pepemanboy/sumitomo_cpgs/electronics/cpg_slave_sch.PDF

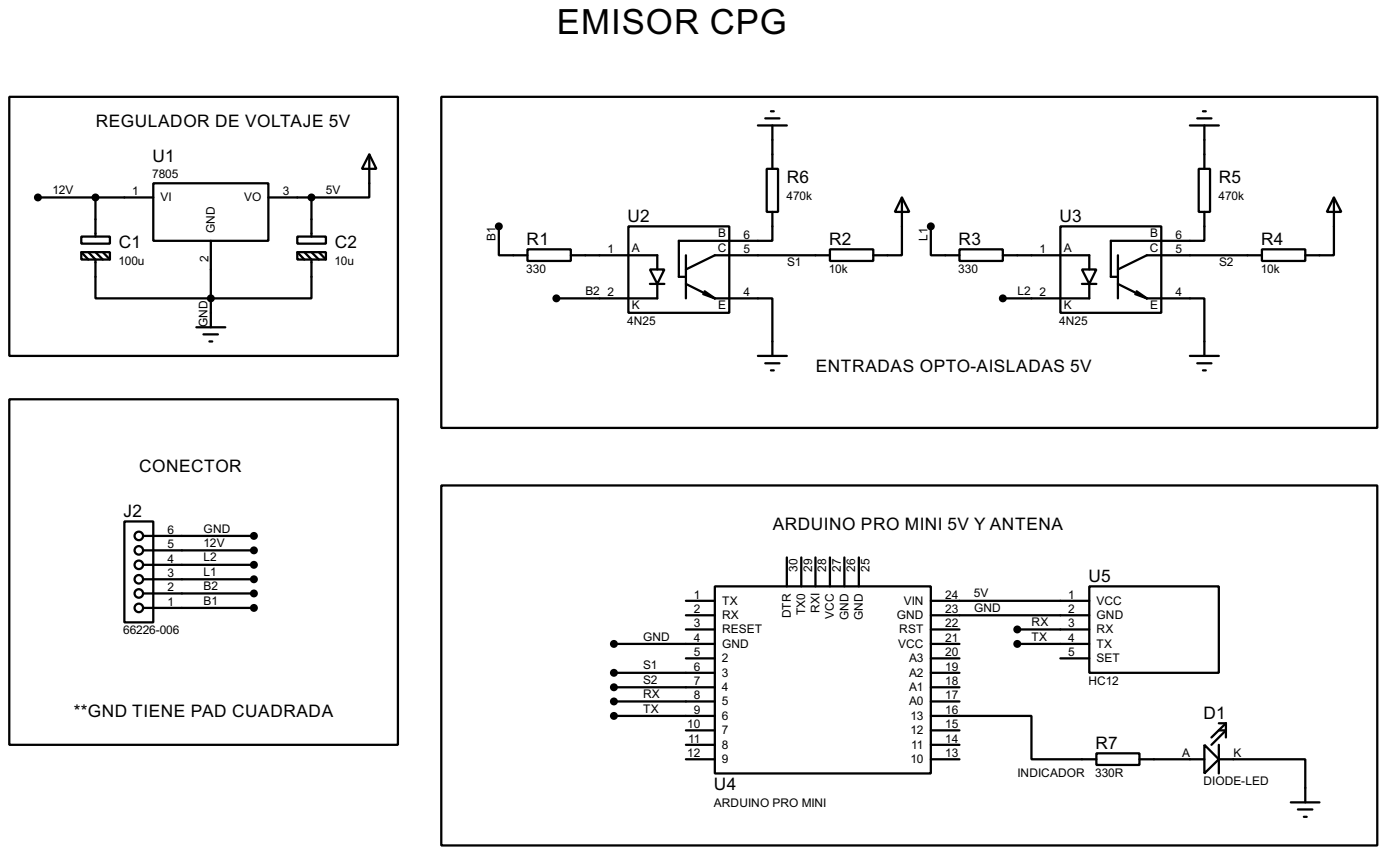
[picture p3: page 1]

ARDUINO PRO MINI 5V Y ANTENA

**GND TIENE PAD CUADRADA
