pepemanboy/sumitomo_cpgs/src/sumitomo_cpgs_master.h

/** @file
  CPG Master implementation

  Defines the CPG_Master class, wich inherits from CPG. 

  @date 2019-01-31
  @author pepemanboy

  Copyright 2019 Cirotec Automation

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
  THE SOFTWARE IS PROVIDED "AS IS", WITHOUT WARRANTY OF ANY KIND, EXPRESS OR 
  IMPLIED, INCLUDING BUT NOT LIMITED TO THE WARRANTIES OF MERCHANTABILITY, 
  FITNESS FOR A PARTICULAR PURPOSE AND NONINFRINGEMENT. IN NO EVENT SHALL THE 
  AUTHORS OR COPYRIGHT HOLDERS BE LIABLE FOR ANY CLAIM, DAMAGES OR OTHER 
  LIABILITY, WHETHER IN AN ACTION OF CONTRACT, TORT OR OTHERWISE, ARISING FROM, 
  OUT OF OR IN CONNECTION WITH THE SOFTWARE OR THE USE OR OTHER DEALINGS IN THE 
  SOFTWARE.
*/

#include "sumitomo_cpgs_common.h"
#include "sumitomo_cpgs_config.h"

#ifndef SUMITOMO_CPGS_MASTER_H
#define SUMITOMO_CPGS_MASTER_H

class CPG_Master:CPG
{

private:
  /// GET CONFIGURATION FROM FILE
  const static uint8_t slave_number_ = {
    SUMITOMO_CPGS_CONFIG_SLAVE_NUMBER
  }; ///< Number of slaves for this master
  const uint8_t slaves_[slave_number_] = {
     #include "../cfg/slaves_config.h"
  }; ///< Slaves addressable by this master
  const static uint8_t master_channel_ = {
    #include "../cfg/master_channel_config.h"
  }; ///< Master HC12 channel

  /// CONFIGURATION
  const static pin_t led_blue_ = 8; ///< Blue LED
  const static pin_t hc12_tx_ = 3; ///< HC12 Tx pin
  const static pin_t hc12_rx_ = 2; ///< HC12 Rx pin
  const static pin_t hc12_set_ = 7; ///< HC12 Set pin
  
  const static uint16_t rx_blink_ms_ = 200; ///< Blink time on RX
  const static uint32_t init_period_ms_ = 60000 + (master_channel_*10); ///< Init query period
  const static uint32_t slave_period_ms_ = 1000; ///< Slave query period
  const static uint16_t serial_timeout_ms_ = 1000; ///< Serial timeout [ms]

  /// VARIABLES
  uint32_t led_timestamp_ = 0; ///< Timestamp of LED turn on
  uint32_t serial_timestamp_ = 0; ///< Timestamp of serial
  uint32_t init_timestamp_ = 0; ///< Timestamp for last init query
  uint32_t slave_timestamp_ = 0; ///< Timestamp for slave querying

  uint8_t sequences_[slave_number_] = {0}; ///< Sequences of slaves
  uint32_t slaves_mask_ = 0;


public:
  /** Constructor */
  CPG_Master():
  CPG(hc12_tx_,hc12_rx_,hc12_set_, led_blue_, serial_timeout_ms_)
  {
    setAddress(master_address_);
    slaves_mask_ = 0;
    for (uint8_t i = 0; i < slave_number_; ++i)
      slaves_mask_ |= ((uint32_t)1)<<slaves_[i];    
  }

/// PACKET QUERIES
private:
  /** Query CPG Info */
  void queryCPGInfo(uint8_t address, const CPGInfoQuery * c)
  {
    queryPacket(address, cmd_CPGInfoQuery, (uint8_t *)c, sizeof(CPGInfoQuery)); 
  }

  /** Query CPG Init */
  void queryCPGInit(const CPGInitQuery * c)
  {
    queryPacket(broadcast_address_, cmd_CPGInitQuery, (uint8_t *)c, sizeof(CPGInitQuery)); 
  }
  
private:
  /** Setup led module */
  void ledSetup()
  {
    pinMode(led_blue_, OUTPUT);
    ledControl(led_blue_, led_On);
  }

  void ledBlinkStart()
  {
    ledControl(led_blue_, led_On);
    led_timestamp_ = millis();
  }

  void ledBlinkReset()
  {
    if ((millis() - led_timestamp_) > rx_blink_ms_)
      ledControl(led_blue_, led_Off);
  }

public: 
  /** Setup */ 
  void setup()
  {
    USB.begin(usb_baudrate_);
    
    ledSetup();
    HC12_setup_retry(home_channel_);
      
    CPGInitQuery c = {
      .cpg_channel = master_channel_, 
      .cpg_address = slaves_mask_
    };

    queryCPGInit(&c);
    debug((char *)"Sent query CPG Init");
    delay(100);
    
    HC12_setup_retry(master_channel_);
  }

  /** Loop */
  void loop() 
  {    
    res_t r = Ok;
    
    ledBlinkReset();

    for (uint8_t i; i < slave_number_; ++i)
    {
      // Time control
      while ((millis() - slave_timestamp_) < slave_period_ms_)
      {
        ledBlinkReset();
        delay(10);
      }
      slave_timestamp_ = millis();

      // Reset blinking LED
      ledBlinkReset();

      // Clean rx buffer
      while(HC12.available()) 
        HC12.read();

      // Query Info
      CPGInfoQuery c = {.cpg_sequence = sequences_[i]};
      queryCPGInfo(slaves_[i], &c);

      // Debug
      #ifdef DEBUG
      char buf[10] = "";
      sprintf(buf, "qry slv %d", slaves_[i]);
      debug(buf);
      #endif

      // Wait for reply
      size_t l = HC12.readBytesUntil(0, rx_buffer_, sizeof(rx_buffer_));

      // Process reply
      if (l)
      {        
        debug((char *)"Received reply");
        packet_t *p = &rx_packet_;
        r = packetRx(p, rx_buffer_, l);
        if (r == Ok) 
        {                
          if (p->command == cmd_CPGInfoReply && 
            p->data_size == sizeof(CPGInfoReply)) 
          {
            CPGInfoReply *rpy = (CPGInfoReply*)p->data;
            if (rpy->cpg_id == slaves_[i])
            {
              sequences_[i] = rpy->cpg_sequence;
              for (uint8_t j = 0; j < rpy->cpg_count; ++j)
                USB.println(rpy->cpg_id);
              ledBlinkStart();
            }
            else // Id mismatch
            {
              debug((char *)"Id error");
              r = EId;
            }
          }
          else // Command mismatch
          {
            debug((char *)"Command error");
            r = ECommand;            
          }
        }
      }
      else
      {
        debug((char *)"No reply");
      }

    }

    // Send slaves
    if ((millis() - init_timestamp_) > init_period_ms_)
    {
      debug((char *)"Send init");
      HC12_setup_retry(home_channel_);
      CPGInitQuery c = {
      .cpg_channel = master_channel_, 
      .cpg_address = slaves_mask_
      };
      queryCPGInit(&c);
      delay(100);
      HC12_setup_retry(master_channel_);
      debug((char *)"Finish sending init");
      init_timestamp_ = millis();
    }

  }
};

#endif // SUMITOMO_CPGS_MASTER_H
