pepemanboy/sumitomo_cpgs/sumitomo_cpgs_master.h

#include "sumitomo_cpgs_common.h"
#include "sumitomo_cpgs_config.h"

class CPG_Master:CPG
{

private:
  /// CONFIGURATION
  const static pin_t led_blue_ = 8; ///< Blue LED
  const static pin_t hc12_tx_ = 3; ///< HC12 Tx pin
  const static pin_t hc12_rx_ = 2; ///< HC12 Rx pin
  const static pin_t hc12_set_ = 7; ///< HC12 Set pin
  
  const static uint16_t rx_blink_ms_ = 200; ///< Blink time on RX
  const static uint8_t master_channel_ = cpg_MASTER_CHANNEL; ///< Master HC12 channel
  const static uint16_t reply_timeout_ms = 100; ///< Reply timeout
  
  const static uint8_t slave_number_ = cpg_SLAVE_NUMBER; ///< Number of slaves for this master
  const uint8_t slaves_[cpg_SLAVE_NUMBER] = cpg_SLAVES; ///< Slaves for this master

  const static uint8_t fault_threshold_ = 10; ///< Allowed consecutive faults from a slave

  /// VARIABLES
  uint32_t led_timestamp_ = 0; ///< Timestamp of LED turn on
  uint32_t serial_timestamp_ = 0; ///< Timestamp of serial

  uint8_t sequences_[slave_number_] = {0}; ///< Sequences of slaves
  uint8_t faults_[slave_number_] = {0}; ///< Faults of slaves

public:
  /** Constructor */
  CPG_Master():
  CPG(hc12_tx_,hc12_rx_,hc12_set_, led_blue_)
  {
    setAddress(master_address_);
  }

/// PACKET QUERIES
private:
  /** Query CPG Info */
  void queryCPGInfo(uint8_t address, const CPGInfoQuery * c)
  {
    queryPacket(address, cmd_CPGInfoQuery, (uint8_t *)c, sizeof(c)); 
  }

  /** Query CPG Init */
  void queryCPGInit(const CPGInitQuery * c)
  {
    queryPacket(broadcast_address_, cmd_CPGInitQuery, (uint8_t *)c, sizeof(c)); 
  }
  
private:
  /** Setup led module */
  void ledSetup()
  {
    pinMode(led_blue_, OUTPUT);
    ledControl(led_blue_, led_On);
  }

public: 
  /** Setup */ 
  void setup()
  {
    USB.begin(usb_baudrate_);
    
    ledSetup();
    res_t res = HC12_setup(home_channel_);
    if (res != Ok)
      error();
      
    uint32_t init_slaves_ = 0;
    for (uint8_t i = 0; i < slave_number_; ++i)
      init_slaves_ |= 1<<slaves_[i];    
      
    CPGInitQuery c = {.cpg_channel = master_channel_, .cpg_address = init_slaves_};
    queryCPGInit(&c);
    
    HC12_setup(master_channel_);
  }

  /** Loop */
  void loop() 
  {
    res_t r = Ok;
    uint32_t init_slaves_ = 0;
    for (uint8_t i; i < slave_number_; ++i)
    {
      // Clean rx buffer
      while(HC12.available()) 
        HC12.read();

      // Query Info
      CPGInfoQuery c = {.cpg_sequence = sequences_[i]};
      queryCPGInfo(slaves_[i], &c);

      // Wait for reply
      size_t l = HC12.readBytesUntil(0, rx_buffer_, sizeof(rx_buffer_));

      // Process reply
      if (l)
      {        
        packet_t *p = &rx_packet_;
        r = packetRx(p, rx_buffer_, l-1);
        if (r == Ok) 
        {                
          if (p->command == cmd_CPGInfoReply && p->data_size == sizeof(CPGInfoReply)) 
          {
            CPGInfoReply *rpy = (CPGInfoReply*)&p->data;
            if (rpy->cpg_id == slaves_[i])
            {
              sequences_[i] = rpy->cpg_sequence;
              for (uint8_t j = 0; j < rpy->cpg_count; ++j)
                USB.println(rpy->cpg_id);
              faults_[i] = 0;
            }
            else // Id mismatch
              r = EId;
          }
          else // Command mismatch
            r = ECommand;            
        }
      }
      else // No incoming data
      {
        ++faults_[i];
        if (faults_[i] > fault_threshold_)
          init_slaves_ |= 1<<slaves_[i];
      }
    }

    if (init_slaves_)
    {
      HC12_setup(home_channel_);
      CPGInitQuery c = {.cpg_channel = master_channel_, .cpg_address = init_slaves_};
      queryCPGInit(&c);
      HC12_setup(master_channel_);
    }
  }
};
