pepemanboy/sumitomo_cpgs/(commit log)

2019-02-02 Added slave debugs and leds
2019-02-02 Fix typo and add static types
    [sumitomo_cpgs_slave.h]
2019-02-02 add missing return, fix length bug, and add debugging
    [sumitomo_cpgs_common.h, sumitomo_cpgs_slave.h]
2019-02-02 Fix length bug, debug address rx
    [sumitomo_cpgs_common.h, sumitomo_cpgs_master.h]
2019-02-11 Fix address uint32 issue. Add debugging and change LED behavior.
    [sumitomo_cpgs_common.h, sumitomo_cpgs_master.h, sumitomo_cpgs_slave.h]
